JQIamo/Rb-Dispenser-pwr-supp/README.md

# Rb-Dispenser-pwr-supp
Power supply for rubidium dispenser.
