JQIamo/Rb-Dispenser-pwr-supp/eagle/schematic1.brd

## EAGLE design eagle/schematic1.brd (2020-11-10)

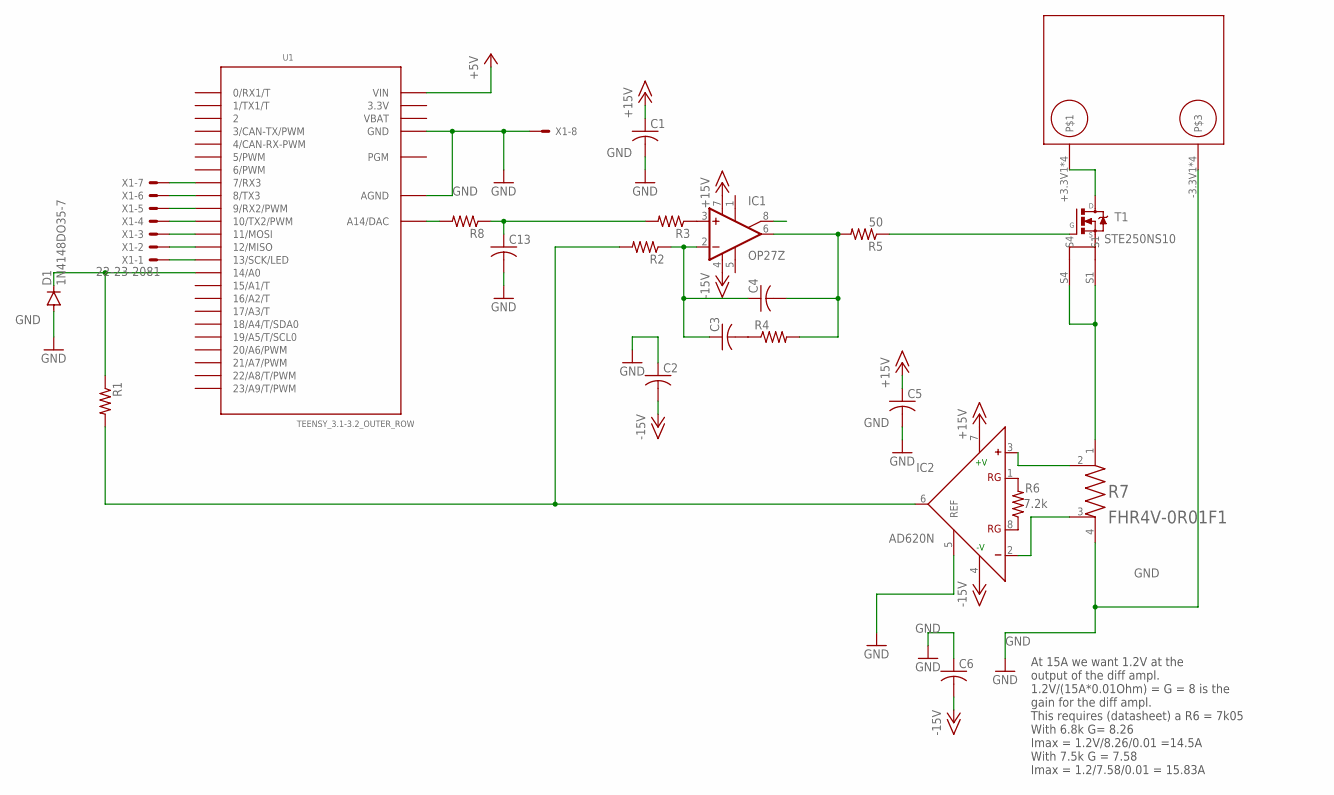
[picture p1: schematic schematic1.sch, sheet 1]

Parts:
C1, C2, C3, C4, C5, C6, C13: C-US025-024X044; C025-024X044
D1: 1N4148DO35-7; DO35-7
IC1: OP27Z; DIL08
IC2: AD620N; DIL08
J1: MOLEX_0399200502; 3.3V_HOOKIN
R1, R2, R3, R4, R8: R-US_0204/7; 0204/7
R5: 50; 0204/7
R6: 7.2k; 0204/7
R7: FHR4V-0R01F1; RIEDON_FHR4V-0R1F1
T1: STE250NS10
U1: TEENSY_3.1-3.2_OUTER_ROW; TEENSY_3.0-3.2&LC_OUTER_ROW
X1: 22-23-2081; DIGIKEY ED10566-ND

Connections:
3.3V: U1.3.3V, U1.3.3V1 (3.3V)
+5V: U1.VIN; also elsewhere on the board
+15V: C1.1, C5.1, IC1.7 (V+), IC2.7 (+V); also elsewhere on the board
-15V: C2.2, C6.2, IC1.4 (V-), IC2.4 (-V); also elsewhere on the board
GND: C1.2, C2.1, C5.2, C6.1, C13.2, D1.A, IC2.5 (REF), J1.-3.3V1, J1.-3.3V2, J1.-3.3V3, J1.-3.3V4, R7.4, U1.AGND, U1.GND, U1.GND1 (GND), X1.8; also elsewhere on the board
unnamed: U1.7 (7/RX3), X1.7
unnamed: J1.+3.3V1, J1.+3.3V2, J1.+3.3V3, J1.+3.3V4, T1.D
unnamed: D1.C, R1.1, U1.14/A0
unnamed: IC2.1 (RG), R6.2
unnamed: IC2.8 (RG), R6.1
unnamed: U1.8 (8/TX3), X1.6
unnamed: IC2.6 (OUT), R1.2, R2.2
unnamed: C3.1, C4.1, IC1.2 (-IN), R2.1
unnamed: IC1.3 (+IN), R3.1
unnamed: R8.2, U1.RESET/DAC (A14/DAC)
unnamed: C4.2, IC1.6 (OUT), R4.2, R5.2
unnamed: R5.1, T1.G
unnamed: C3.2, R4.1
unnamed: C13.1, R3.2, R8.1
unnamed: U1.9 (9/RX2/PWM), X1.5
unnamed: R7.1, T1.S1, T1.S4
unnamed: IC2.3 (+), R7.2
unnamed: IC2.2 (-), R7.3
unnamed: U1.10 (10/TX2/PWM), X1.4
unnamed: U1.11 (11/MOSI), X1.3
unnamed: U1.12 (12/MISO), X1.2
unnamed: U1.13 (13/SCK/LED), X1.1
VBAT: U1.VBAT

Notes on the sheet:
At 15A we want 1.2V at the output of the diff ampl. 1.2V/(15A*0.01Ohm) = G = 8 is the gain for the diff ampl. This requires (datasheet) a R6 = 7k05 With 6.8k G= 8.26 Imax = 1.2V/8.26/0.01 =14.5A With 7.5k G = 7.58 Imax = 1.2/7.58/0.01 = 15.83A

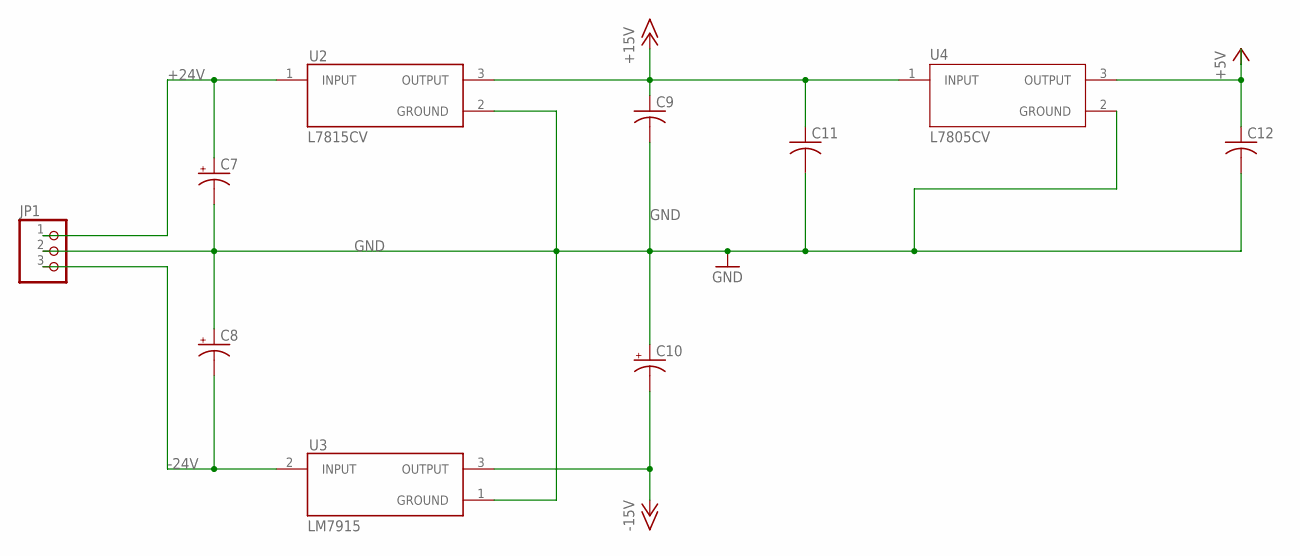
[picture p2: schematic schematic1.sch, sheet 2]

Parts:
C7, C8, C10: CPOL-USTT2D4; TT2D4
C9, C11, C12: C-US025-024X044; C025-024X044
JP1: PINHD-1X3; 1X03
U2: L7815CV; TO255P1040X460X1935-3
U3: LM7915; TO255P1040X460X1935-3
U4: L7805CV; TO255P1040X460X1968-3

Connections:
+5V: C12.1, U4.3 (OUTPUT); also elsewhere on the board
+15V: C9.1, C11.1, U2.3 (OUTPUT), U4.1 (INPUT); also elsewhere on the board
+24V: C7.+, JP1.1, U2.1 (INPUT)
-15V: C10.-, U3.3 (OUTPUT); also elsewhere on the board
-24V: C8.-, JP1.3, U3.2 (INPUT)
GND: C7.-, C8.+, C9.2, C10.+, C11.2, C12.2, JP1.2, U2.2 (GROUND), U3.1 (GROUND), U4.2 (GROUND); also elsewhere on the board

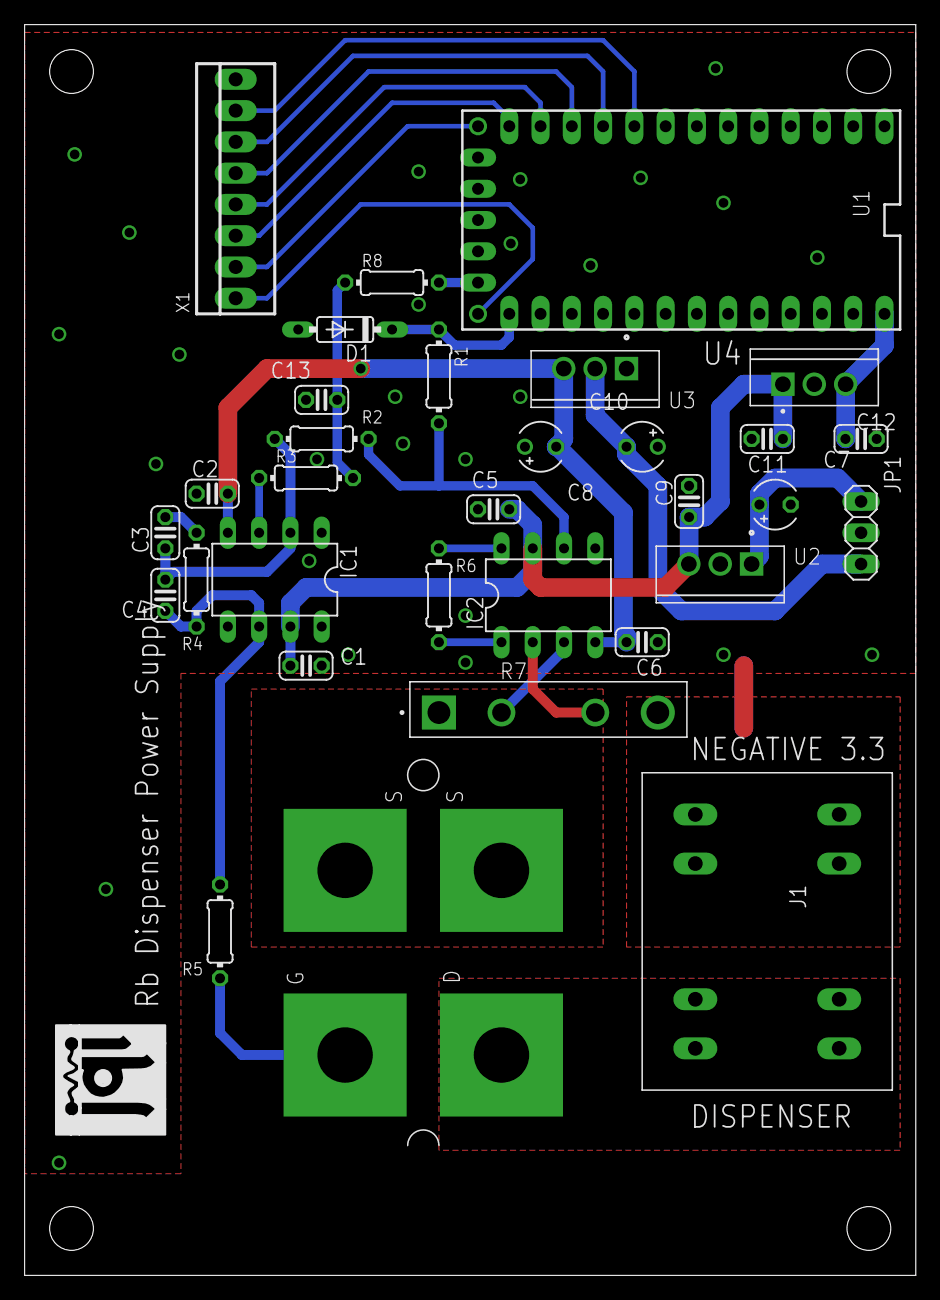
[picture p3: board schematic1.brd from above]

Board: 2 copper layers, 72.4 x 101.6 mm, 33 parts (0 on the bottom side), 29 nets.

Other parts of the board:
LOGO1: JQI-LOGOSILK; JQI_LOGO_NEGATIVE-SILKSCREEN
