JQIamo/Rb-Dispenser-pwr-supp/(commit log)

2020-10-29 added eagle design
    [schematic1.brd, schematic1.sch]
2020-10-29 Fixed MOS package - H and V dim are different - Holes are M4 and not M6
    [schematic1.brd, schematic1.sch]
2020-10-29 Fixed wrong pinout for negative regulator - This is a classic error that often goes unnoticed. TO2020 Negative regulators have the pinout: 1-GND 2-INPUT 3-OUTPUT This is different from positive regul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
    [schematic1.brd, schematic1.sch]
2020-10-30 Removed resistor reordered parts and added LPF
    - Resistor from pin 1 and 8 of OP27 is a mistake and it was removed.
    - Components name re-ordered and re-assigned
    - RC filter added after Teensy DAC. It might be necessary to filter
    out digital interference (especially from USB port)
    [schematic1.brd, schematic1.sch]
2020-11-10 Changed value of sensing resistor to 0.01Ohm and added value for R6 TO DO: 1 - Add missing values for resistors and capacitors according with the prototype board 2 - Fix the hole size for the large 3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
    [schematic1.brd, schematic1.sch]
2020-11-11 added code example for arduino
